Sungsic-Lee/Aqua_Man_Project/README.md

# Aqua_Man_Project
2020_ESW_Contest_자유공모-레이저 유도 자동화 소방시스템

Youtube Link : https://youtu.be/ipkOx77Ax5k

KakaoTalk_20200927_024653579

------------

* Anchor.ino, TAG.ino - Arduino Nano (Custumed by 3.3V 8Mhz)
* Mega.ino            - Arduino Mega
* Water_Pump          - Arduino Nano
* Raspberry_Pi.py     - RaspberryPi 4 4GB
