Sungsic-Lee/Aqua_Man_Project/src/README.md

# Aqua_Man_Project
 2020_ESW_Contest_자유공모-레이저 유도 자동화 소방시스템
 <br/>
 <br/>
 
 <br/>
